rain-1/nora-b106/square-p3/programming/README.md

# First tests: Dragon P3.2 (P1-compatible pinout)

This low-cost CMSIS-DAP route has now passed basic SWD, LED, flash and UART
tests on one minimum assembly with a Pico 2 W. See [the bring-up record](BRINGUP.md)
and [separate BLE firmware](../firmware/ble/README.md). USB is still untested.
The NORA-B106 uses a dual-core nRF5340; use software with
nRF53 support, not an nRF52 target file. The manufacturer's documented supported
programmer route is SEGGER J-Link. Keep that as a fallback if your particular
Pico firmware/tool version cannot attach or recover this device.

## Set up the Pico

Use the official Raspberry Pi `debugprobe_on_pico.uf2` release for an RP2040
Pico, or `debugprobe_on_pico2.uf2` for Pico 2. Hold BOOTSEL while connecting the
Pico by USB and copy the matching UF2 onto its USB drive. Do not use the
`debugprobe.uf2` image intended for the separate Debug Probe accessory.

Firmware and instructions:
https://github.com/raspberrypi/debugprobe/releases/tag/debugprobe-v2.3.1
https://www.raspberrypi.com/documentation/microcontrollers/pico-series.html

## OpenOCD version requirement

**Debian 13's packaged OpenOCD 0.12.0 does not support the nRF5340. Installing
`openocd` from its standard repositories is insufficient for these steps.**
Use a newer OpenOCD binary and the scripts installed with that same build;
copying just `nrf53.cfg` into an old installation is insufficient because the
flash driver also needs nRF53 support. Do not substitute `nrf52.cfg`.

One source-build route on Debian 13 is below. This pins the upstream source
revision inspected for this project; it installs under the ignored `build/`
directory and does not replace the system OpenOCD. From the project root:

```sh
sudo apt install build-essential git autoconf automake libtool pkg-config \
  texinfo libusb-1.0-0-dev libhidapi-dev libjim-dev libssl-dev
git clone https://github.com/openocd-org/openocd.git build/tools/openocd-src
git -C build/tools/openocd-src checkout 2893f940012e19cda8ccb6038766b0d77f26bd0e
(
  cd build/tools/openocd-src
  ./bootstrap
  ./configure --prefix="$(pwd)/../openocd" \
    --enable-cmsis-dap --enable-cmsis-dap-v2 --disable-werror
  make -j2
  make install
)
export PATH="$PWD/build/tools/openocd/bin:$PATH"
openocd --version
```

For non-root USB access, install the upstream device rules once, then unplug
and reconnect the Pico:

```sh
sudo install -m 644 build/tools/openocd-src/contrib/60-openocd.rules \
  /etc/udev/rules.d/60-openocd.rules
sudo udevadm control --reload-rules
```

If the source checkout already exists, skip `git clone`. Reapply the PATH line
in each new terminal. Check the target configuration without connecting to
hardware:

```sh
openocd -f programming/pico-nrf53.cfg -c 'noinit; echo [target names]; shutdown'
```

This should list `nrf53.cpuapp` and `nrf53.cpunet`. It proves that the installed
binary can parse the target/flash-driver configuration, not that a Pico can
program a physical module. The project config accepts both the older
`target/nrf53.cfg` and newer `target/nordic/nrf53.cfg` script locations.
Upstream [build instructions](https://github.com/openocd-org/openocd/blob/2893f940012e19cda8ccb6038766b0d77f26bd0e/README.md)
and the [Debian 13 package version](https://packages.debian.org/trixie/openocd)
document the two installation routes. SEGGER J-Link remains the manufacturer's
supported alternative.

In the separate original revision D workspace, that pinned OpenOCD revision was built at
`build/tools/openocd/bin/openocd`, with build dependencies extracted under
`build/tools/openocd-deps/` rather than installed system-wide. The offline
configuration check passed for both cores. These ignored local binaries are
not included in Git or the project ZIP; use the build recipe on a fresh
checkout. No USB adapter or target was connected during this check.

## Wire the target

Connect GND first, then signals, with power removed while wiring.
The Pico pins here refer to the **debugger Pico**, not its own three debug pads.

| Debugger Pico | Physical pin | Carrier |
|---|---|---|
| GND | 3, or another GND | J2 pin 2, GND |
| GP2 | 4 | J2 pin 3, SWCLK |
| GP3 | 5 | J2 pin 4, SWDIO |
| GP1 | 2 | J2 pin 5, RESET_N; optional initially |
| 3V3 OUT | 36 | J2 pin 1 **only with JP1 open and external 3.3 V selected** |

For the USB assembly, fit the complete USB group, bridge JP1, power through USB and leave
Pico 3V3 OUT disconnected. Both variants use 3.3 V signalling. Do not connect
Pico VBUS/VSYS to this 3.3 V header. The Pico firmware has no target voltage
measurement, so verify the rail with a multimeter before connecting signals.

For UART later: J3 pin 3 (target P0.24 TX) goes to Pico GP5 (RX, physical 7),
and J3 pin 4 (target P1.06 RX) goes to Pico GP4 (TX, physical 6). Your firmware
must first configure these target pins as UART.

## Read-only identification

From the project root:

```sh
openocd -f programming/pico-nrf53.cfg \
  -c 'init; targets nrf53.cpuapp; halt; mdw 0x00FF0204 3; shutdown'
```

This attempts to halt the application core and read its FICR device-ID words
and part code. It does not erase or program flash. The CPU remains halted;
power-cycle afterward to restart existing firmware. Successful attach/read
shows that power and basic SWD communication work; it is not a complete
functional test of both cores.

## Blink the LED without building firmware

Connect an external LED: J3 pin 13 (P0.20) → 1 kohm resistor → LED anode,
LED cathode → J3 pin 2 (GND). Then run:

```sh
openocd -f programming/pico-nrf53.cfg -f programming/led-test.cfg
```

The script uses the secure GPIO alias to blink P0.20 six times while halted,
then restores that pin's prior configuration/output. It writes only GPIO
registers, not flash, UICR, or protection settings. It requires unlocked secure
application-core access. With existing firmware that changes security/ownership,
this test may be unavailable even if the board is healthy. If access is denied,
check wiring, supply voltage, adapter firmware, and protection state first.

**Do not blindly run recover/mass erase.** nRF53 recovery can erase both cores
and UICR, including manufacturer production data such as the stored Bluetooth
address. Back up accessible flash/UICR before destructive operations, and use
the manufacturer's recovery/identity-restoration procedure if recovery is
actually necessary. None of the provided scripts performs recovery.

## Built USB firmware

The implemented USB recovery bootloader and GPIO/ADC serial test application
are documented in [Minimal P1 firmware guide](../../minimal-p1/firmware/README.md). The initial SWD
image is `../minimal-p1/firmware/dist/nora-factory.hex`; later USB updates use
`../minimal-p1/firmware/dist/nora-app.signed.bin`. Both have been compiled and statically
checked for the electrically compatible Minimal P1 board, but no hardware programming/USB session has
been tested. Follow the new guide for installation, `nora dfu`, USB uploads and
external GPIO/LED testing. Do not flash the application ELF alone as a factory
image: it needs the signed MCUboot header and matching bootloader.

`../minimal-p1/firmware/blinky/` remains the earlier standalone example source and is not the
USB application. The USB build uses its own board definition rather than the
Nordic DK configuration. No Bluetooth/network-core image is included.

## P3.2 first USB firmware install

P3.2 retains P1's J2/J3 mapping, module power and USB D+/D−/VBUS interfaces.
Its USB-C socket and two CC resistors do not require a firmware change. Use
the unchanged P1 bootloader and application pair (USB names still say P1).
After the power and read-only SWD checks above, fit all USB parts, bridge JP1,
power through USB and disconnect Pico 3V3 OUT. From `square-p3/`:

```sh
openocd -f programming/pico-nrf53.cfg \
  -c 'init; targets nrf53.cpuapp; program ../minimal-p1/firmware/dist/nora-factory.hex verify reset exit'
```

USB serial commands are in the shared firmware guide. `nora pins` lists J3
pins 3–14; the external LED is pin 13, ADC is pin 14. For a later USB update,
run the shared updater from `minimal-p1/`, following that firmware guide.
No P2 firmware should be used on this twelve-GPIO board.

## Optional reset button

If SW1 is fitted, press and release it to reset the target. With the shared P1
USB bootloader installed, a RESET_N reset stays in USB recovery until commanded
to reset. A normal power-on gives the usual eight-second recovery window.
`nora dfu` remains available from the application, and J2 pin 5 still permits an
external reset wire/button if SW1 is omitted. SW1 is not a separate boot-mode
strap and does not change any GPIO header mapping.

## USB-C cable

Use a data-capable USB-A-to-C or USB-C-to-C cable to a computer. Both plug
orientations are wired. Fit R1/R2 and all other USB parts, close JP1 for USB
power, and leave the debugger Pico's 3V3 OUT disconnected. SW1 and `nora dfu`
enter the same shared P1 recovery mode as before. A bare module still needs
its initial SWD installation; changing the connector does not add a ROM USB
bootloader or turn this into a drag-and-drop UF2 drive.
