rain-1/nora-b106/square-p3/artwork/PROMPT.md

# Generation prompt

Tool: built-in `image_gen.imagegen`, new image, opaque white background.

Use case: logo-brand. Asset type: one-colour PCB back silkscreen artwork, to be traced into manufacturing vectors at about 26 mm wide and 23 mm tall. Primary request: a very cool cyber dragon emblem. Draw a single stylized angular cybernetic dragon, serpentine curling neck and tail, recognisable fierce horned head looking to the upper right, one swept segmented bat wing, geometric armour plates and a few thick circuit-trace details. Powerful clean silhouette, elegant balanced asymmetrical composition, compact badge shape with no enclosing border. Flat pure solid black design on a pure white background, large continuous black shapes and broad white cutout spaces. No text, no lettering, no watermarks, no gradients, no grey, no texture, no shading, no simulated PCB, no fine hatching, no tiny dots. Important for fabrication: bold simple details with thick strokes, wide gaps and rounded-safe small corners, read clearly at 26 millimetres; very few broad circuit traces integrated into body rather than a detailed background. Plenty of white margin. This is the black artwork mask only; it will be printed as white ink on green soldermask.
