rain-1/nora-b106/square-p3/artwork/cyber-dragon-source.png

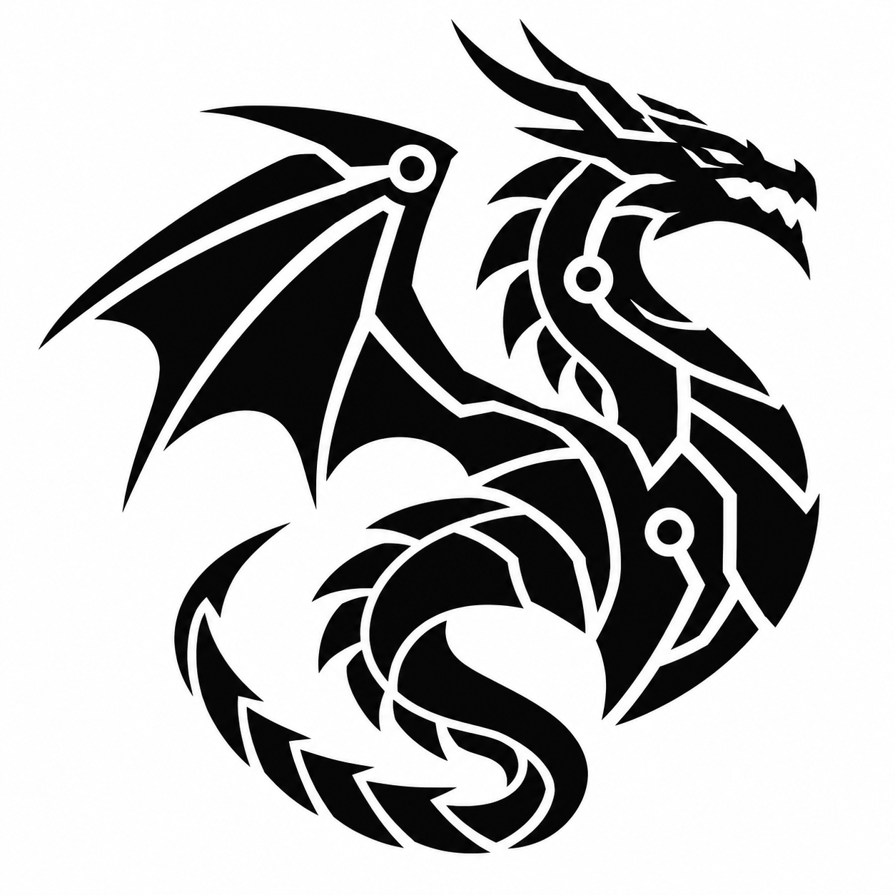
square-p3/artwork/cyber-dragon-source.png
