rain-1/nora-b106/square-p3/preview/back-artwork.png

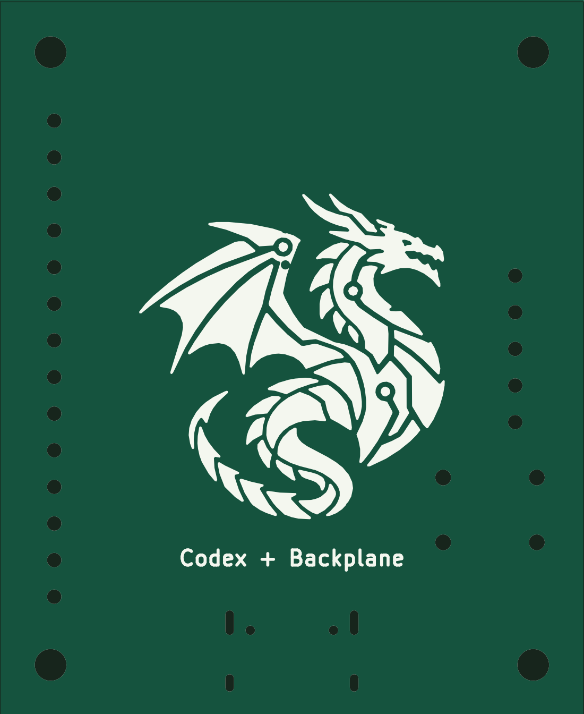
square-p3/preview/back-artwork.png
