rain-1/nora-b106/square-p3/preview/board-top.png

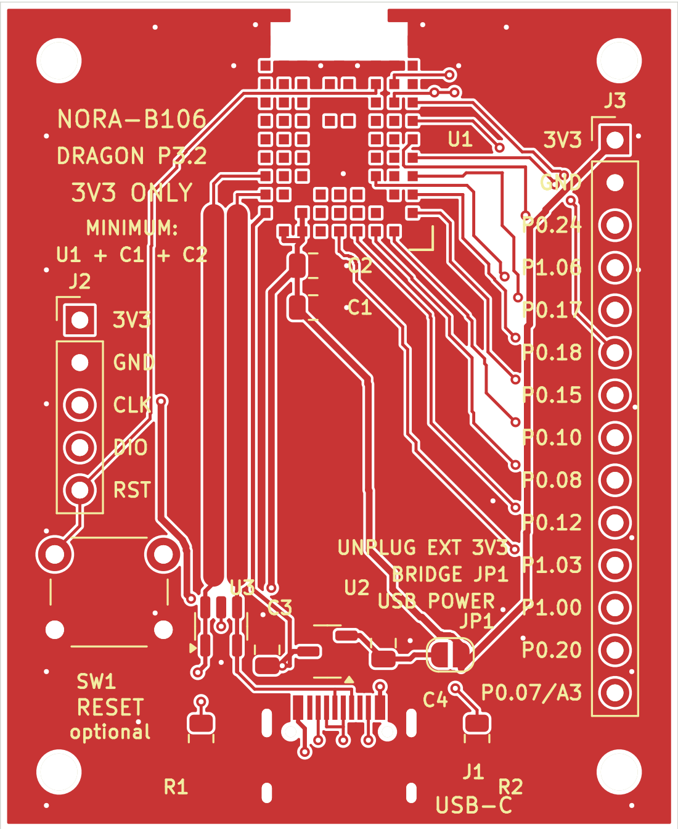
square-p3/preview/board-top.png
