rain-1/nora-b106/square-p3/preview/nora-minimal.png

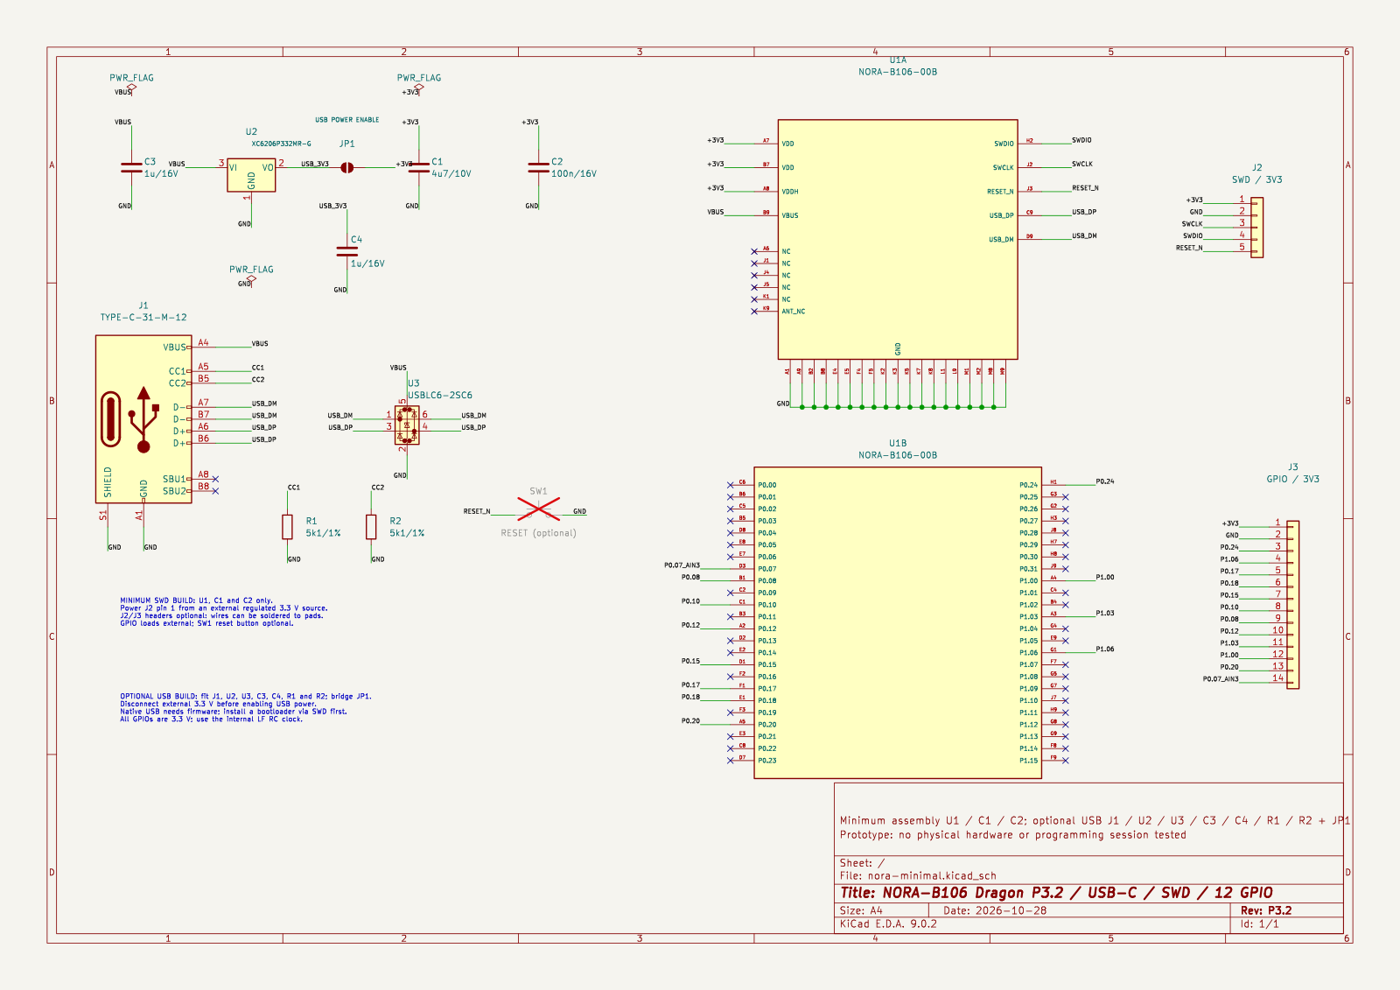
square-p3/preview/nora-minimal.png
