rain-1/nora-b106/fabrication/preview/assembly-top.png

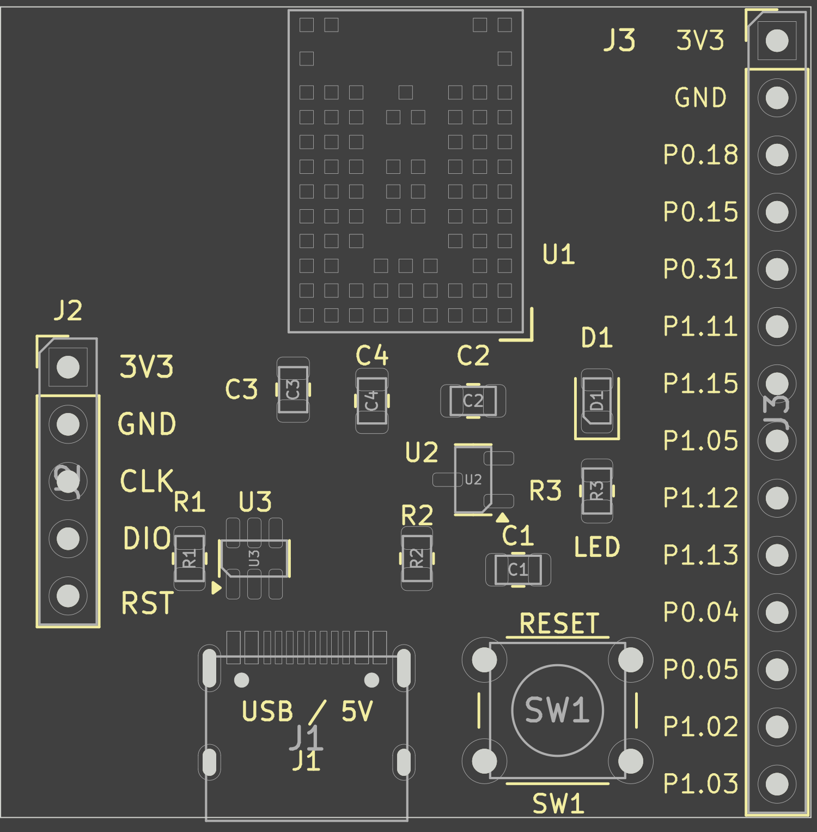
fabrication/preview/assembly-top.png
