rain-1/nora-b106/fabrication/preview/copper-bottom.png

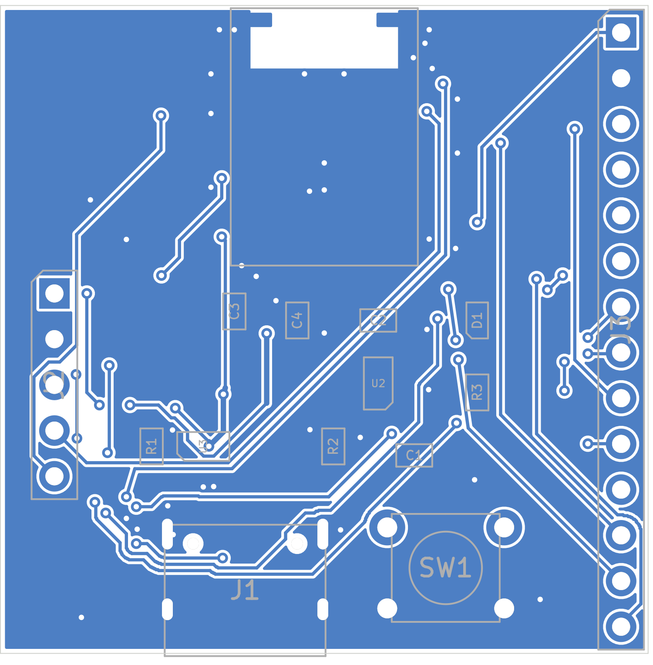
fabrication/preview/copper-bottom.png
