rain-1/nora-b106/fabrication/preview/copper-top.png

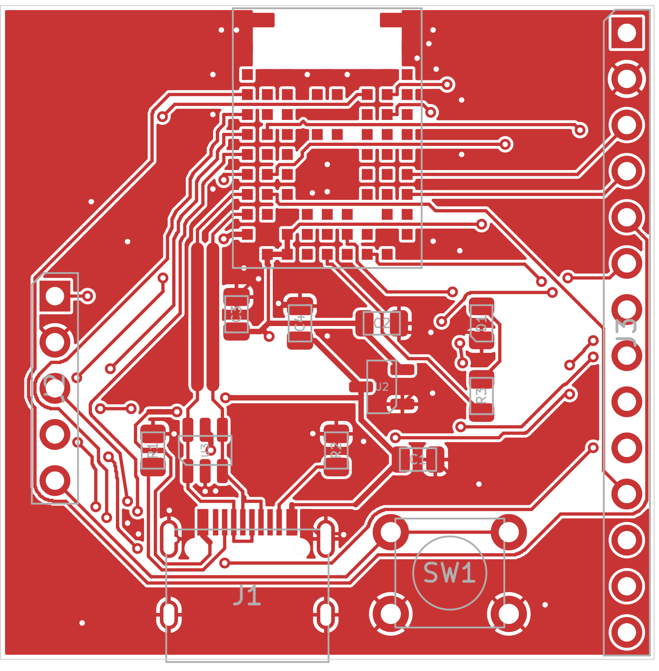
fabrication/preview/copper-top.png
