rain-1/nora-b106/fabrication/preview/nora-b106-board.png

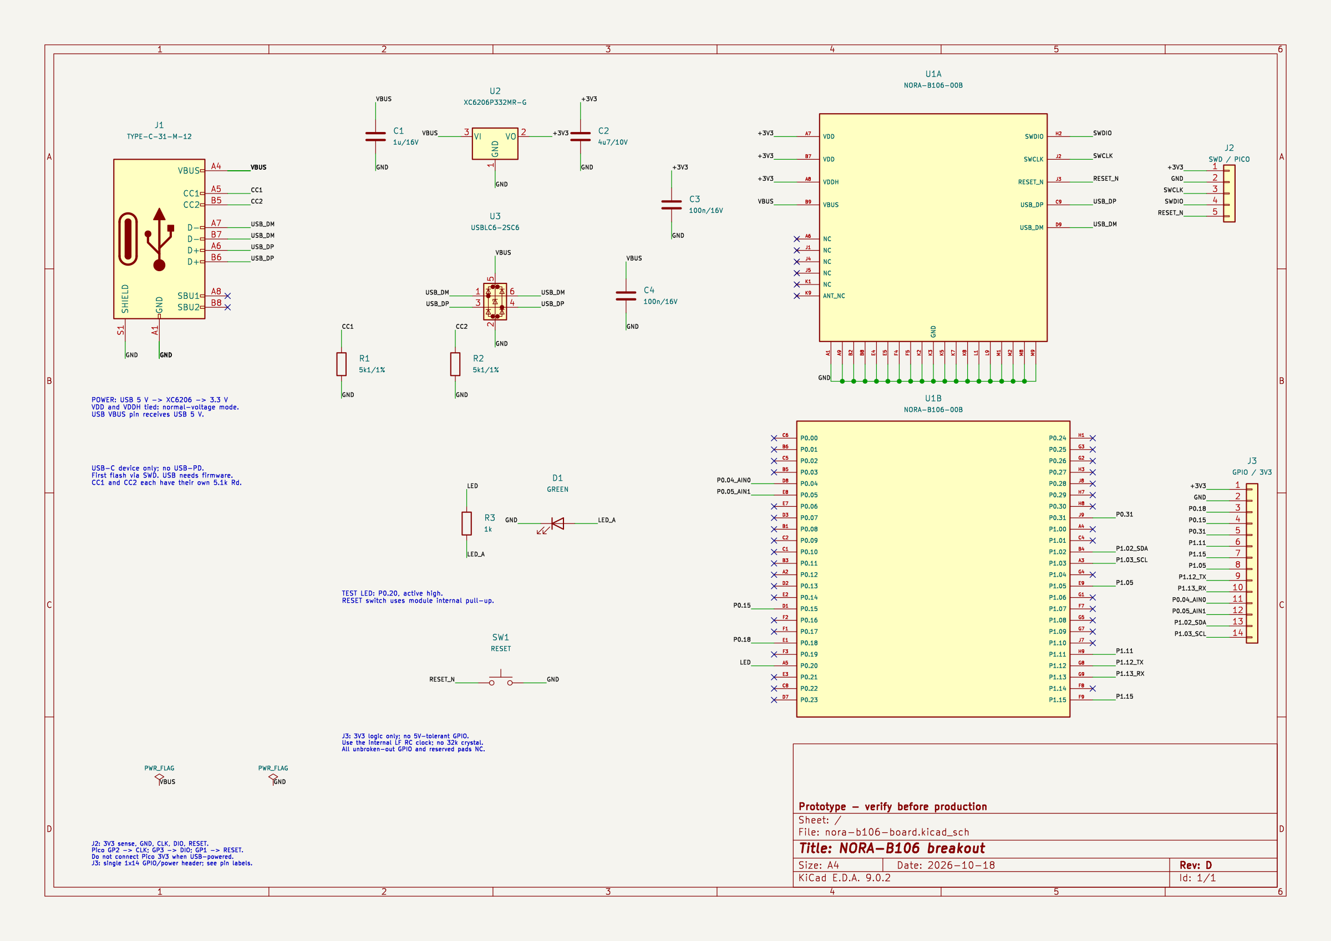
fabrication/preview/nora-b106-board.png
