rain-1/nora-b106/minimal-p1/preview/assembly.png

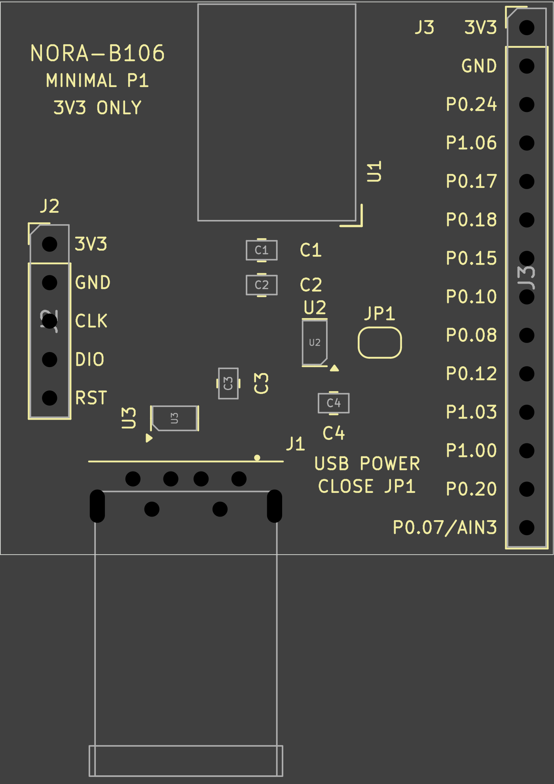
minimal-p1/preview/assembly.png
