rain-1/nora-b106/minimal-p2/preview/assembly.png

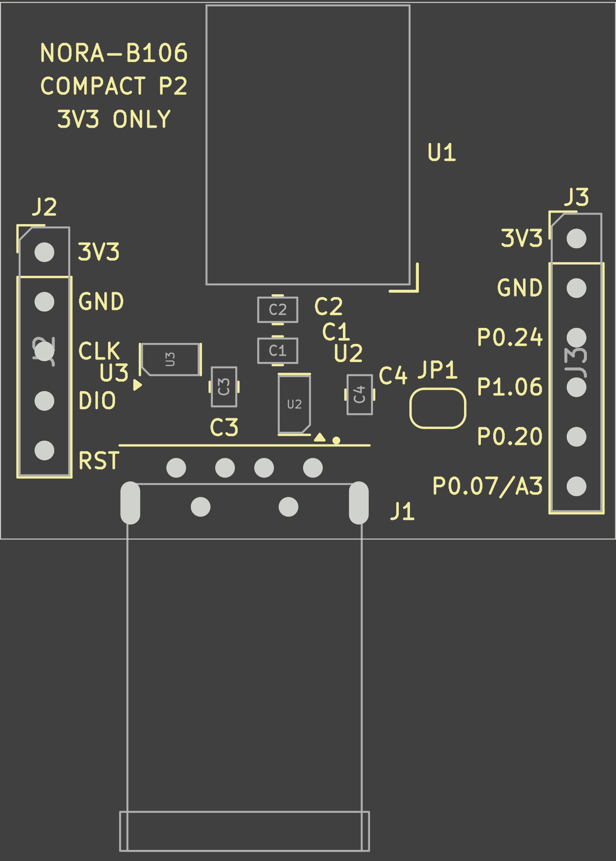
minimal-p2/preview/assembly.png
