rain-1/nora-b106/square-p3/preview/assembly.png

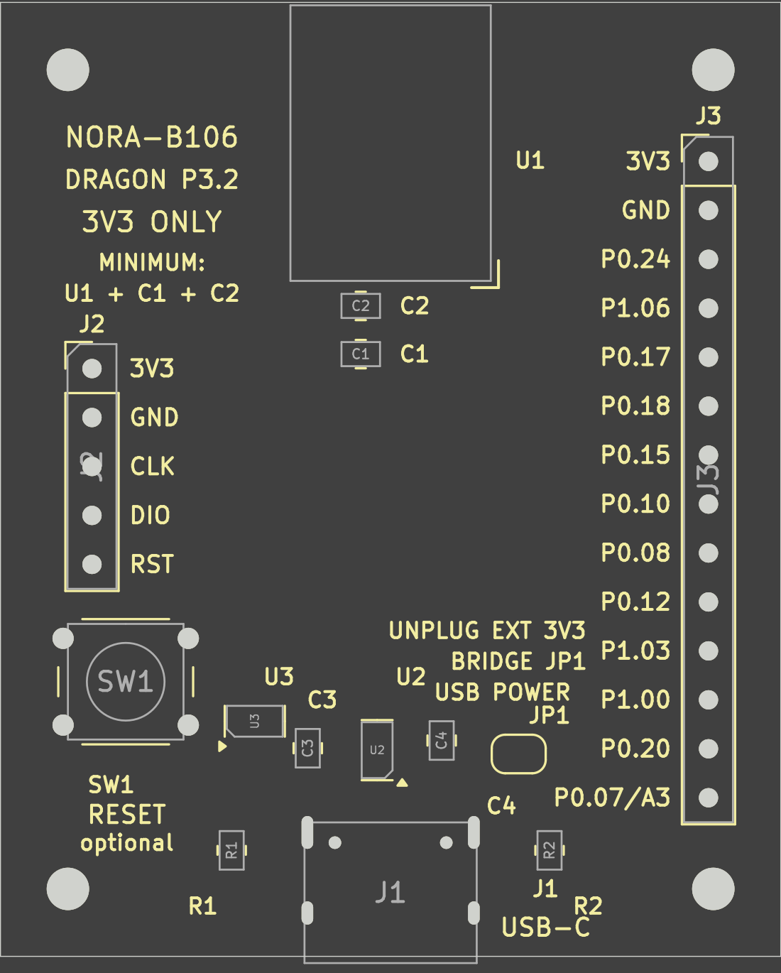
square-p3/preview/assembly.png
