rain-1/nora-b106/square-p3/nora-minimal.kicad_pcb

## KiCad design square-p3/nora-minimal.kicad_pcb (2026-10-28)

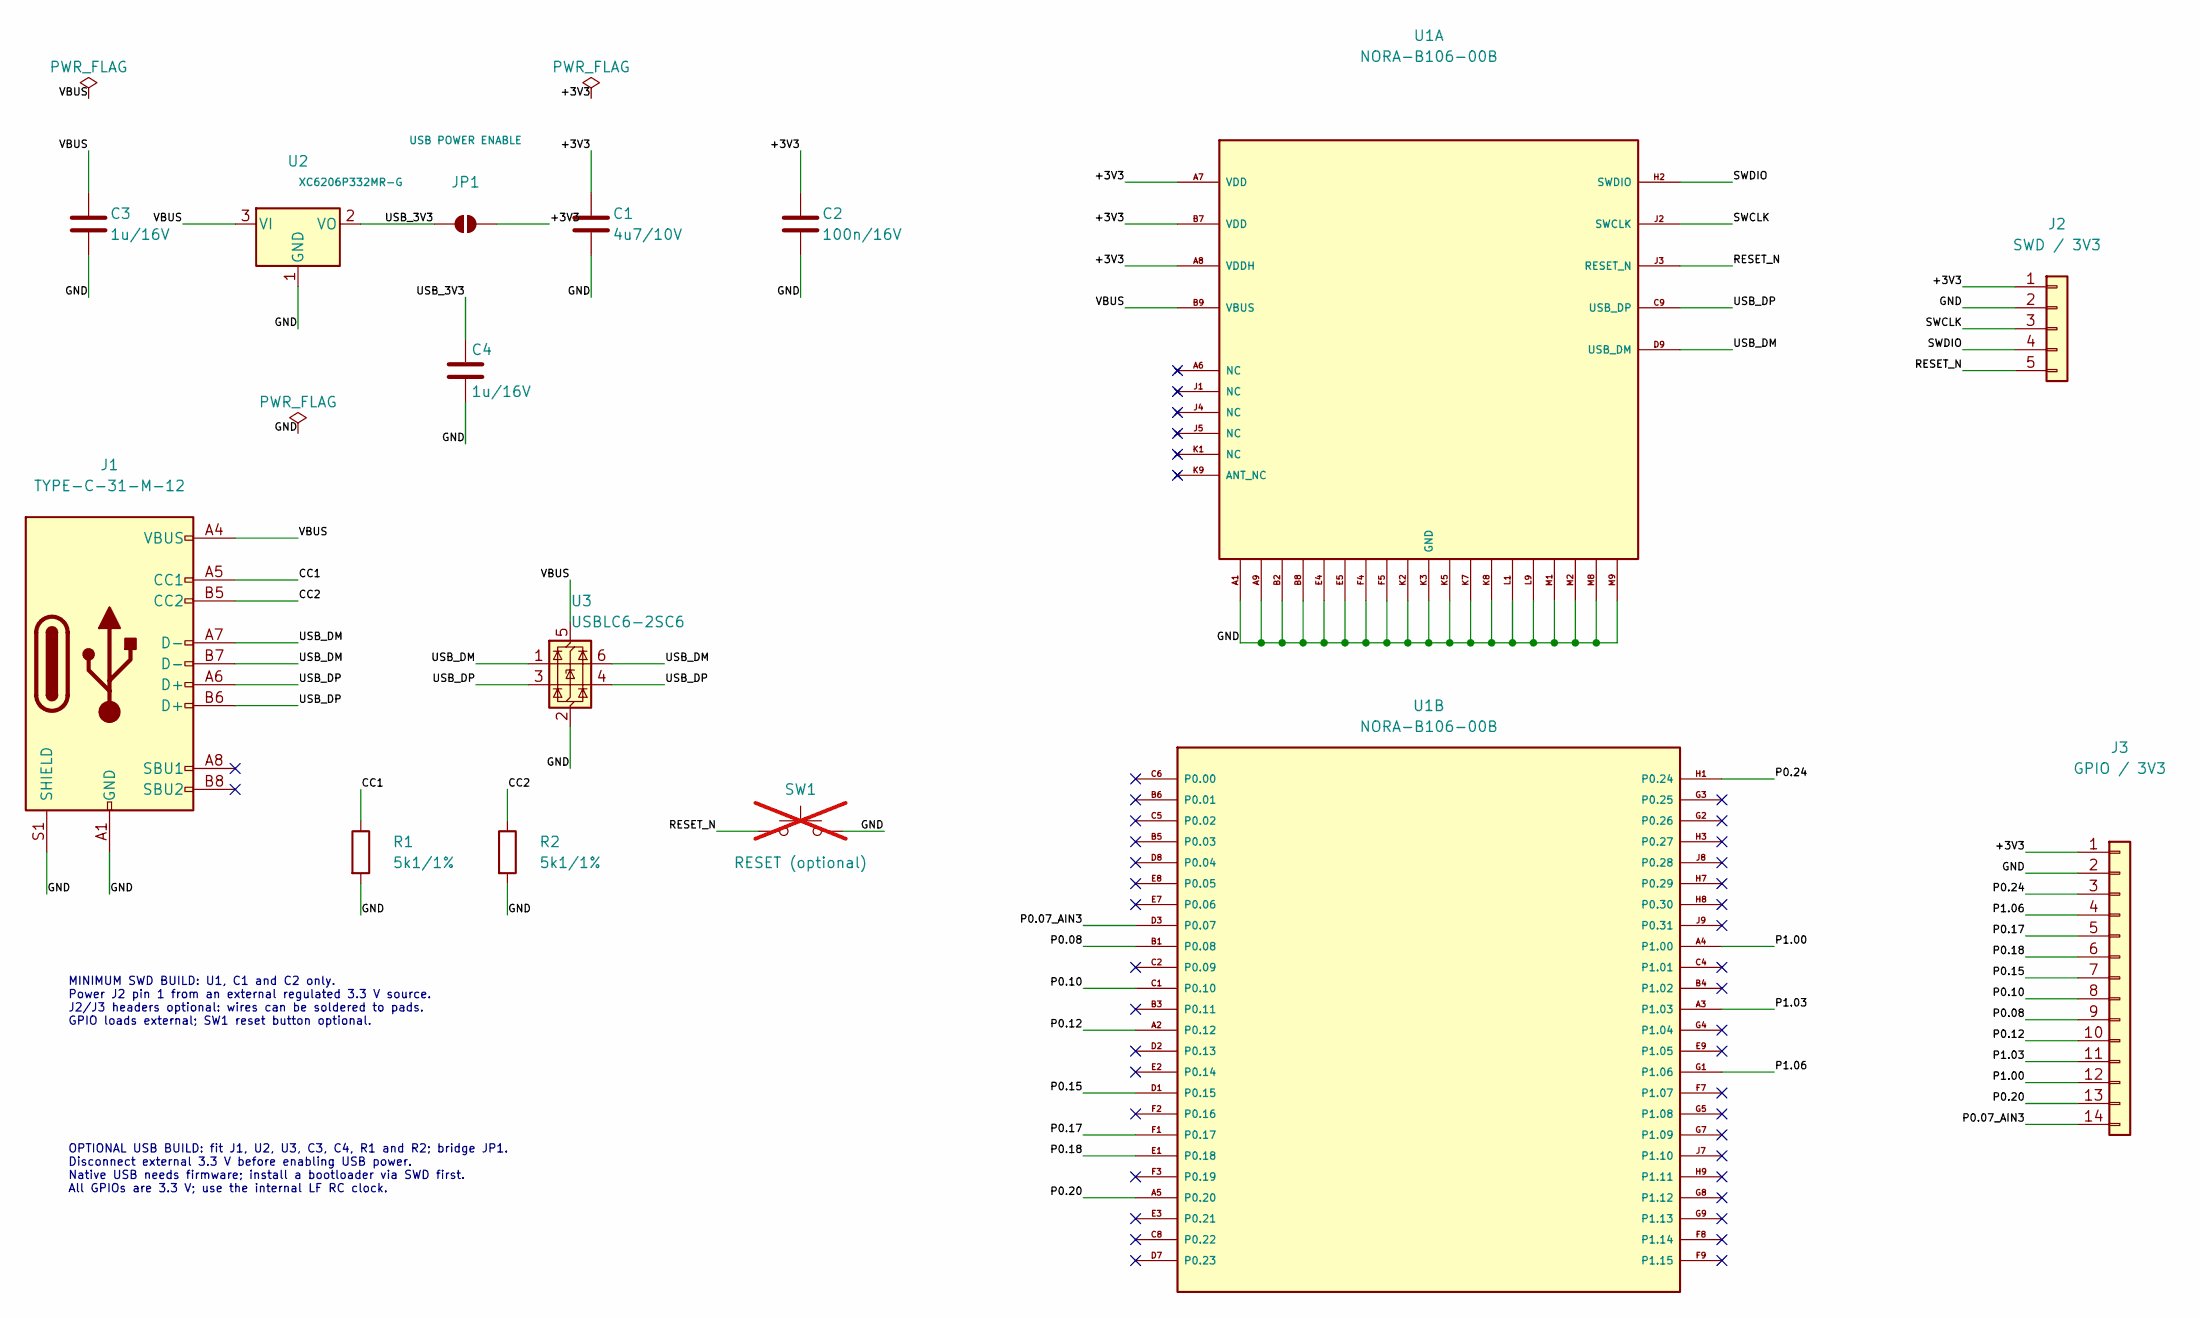
[picture p14: schematic nora-minimal.kicad_sch, NORA-B106 Dragon P3.2 / USB-C / SWD / 12 GPIO]

Parts:
C1: 4u7/10V; C_0805_2012Metric
C2: 100n/16V; C_0805_2012Metric
C3, C4: 1u/16V; C_0805_2012Metric
J1: TYPE-C-31-M-12; USB_C_Receptacle_HRO_TYPE-C-31-M-12
J2: SWD / 3V3; PinHeader_1x05_P2.54mm_Vertical
J3: GPIO / 3V3; PinHeader_1x14_P2.54mm_Vertical
JP1: USB POWER ENABLE; SolderJumper-2_P1.3mm_Open_RoundedPad1.0x1.5mm
R1, R2: 5k1/1%; R_0805_2012Metric
SW1: RESET (optional); SW_PUSH_6mm; not fitted
U1: NORA-B106-00B; NORA-B106
U2: XC6206P332MR-G; SOT-23-3
U3: USBLC6-2SC6; SOT-23-6

Connections:
/+3V3: C1.1, C2.1, J2.1, J3.1, JP1.2 (B), U1.A7 (VDD), U1.A8 (VDDH), U1.B7 (VDD)
/CC1: J1.A5 (CC1), R1.1
/CC2: J1.B5 (CC2), R2.1
/GND: C1.2, C2.2, C3.2, C4.2, J1.A1 (GND), J1.A12 (GND), J1.B1 (GND), J1.B12 (GND), J1.S1 (SHIELD), J2.2, J3.2, R1.2, R2.2, SW1.2, U1.A1, U1.A9, U1.B2, U1.B8, U1.E4, U1.E5, U1.F4, U1.F5, U1.K2, U1.K3 (GND), U1.K5, U1.K7, U1.K8, U1.L1, U1.L9, U1.M1, U1.M2, U1.M8, U1.M9, U2.1 (GND), U3.2 (GND)
/P0.07_AIN3: J3.14, U1.D3 (P0.07)
/P0.08: J3.9, U1.B1 (P0.08)
/P0.10: J3.8, U1.C1 (P0.10)
/P0.12: J3.10, U1.A2 (P0.12)
/P0.15: J3.7, U1.D1 (P0.15)
/P0.17: J3.5, U1.F1 (P0.17)
/P0.18: J3.6, U1.E1 (P0.18)
/P0.20: J3.13, U1.A5 (P0.20)
/P0.24: J3.3, U1.H1 (P0.24)
/P1.00: J3.12, U1.A4 (P1.00)
/P1.03: J3.11, U1.A3 (P1.03)
/P1.06: J3.4, U1.G1 (P1.06)
/RESET_N: J2.5, SW1.1, U1.J3 (RESET_N)
/SWCLK: J2.3, U1.J2 (SWCLK)
/SWDIO: J2.4, U1.H2 (SWDIO)
/USB_3V3: C4.1, JP1.1 (A), U2.2 (VO)
/USB_DM: J1.A7 (D-), J1.B7 (D-), U1.D9 (USB_DM), U3.1 (I/O1), U3.6 (I/O1)
/USB_DP: J1.A6 (D+), J1.B6 (D+), U1.C9 (USB_DP), U3.3 (I/O2), U3.4 (I/O2)
/VBUS: C3.1, J1.A4 (VBUS), J1.A9 (VBUS), J1.B4 (VBUS), J1.B9 (VBUS), U1.B9 (VBUS), U2.3 (VI), U3.5 (VBUS)

Notes on the sheet:
OPTIONAL USB BUILD: fit J1, U2, U3, C3, C4, R1 and R2; bridge JP1. Disconnect external 3.3 V before enabling USB power. Native USB needs firmware; install a bootloader via SWD first. All GPIOs are 3.3 V; use the internal LF RC clock.
MINIMUM SWD BUILD: U1, C1 and C2 only. Power J2 pin 1 from an external regulated 3.3 V source. J2/J3 headers optional: wires can be soldered to pads. GPIO loads external; SW1 reset button optional.

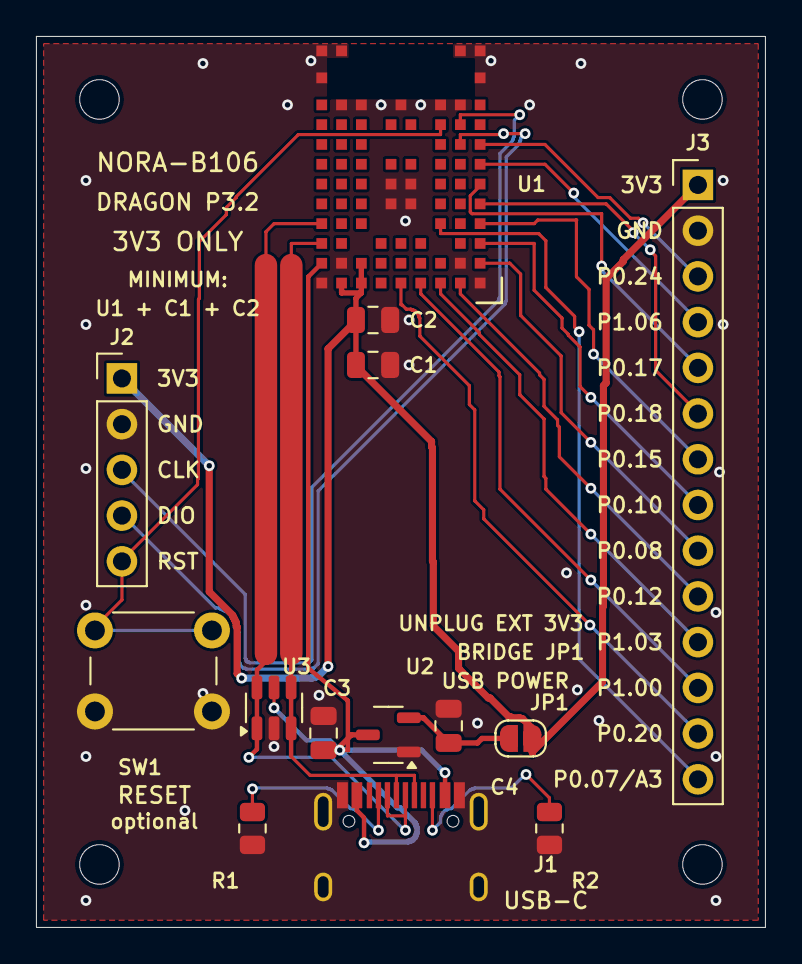
[picture p15: board nora-minimal.kicad_pcb from above]

Board: 2 copper layers, 40.5 x 49.5 mm, 18 parts (0 on the bottom side), 23 nets.

Other parts of the board:
H1, H2, H3, H4: MountingHole_2.2mm_M2
