rain-1/nora-b106/nora-b106-board.kicad_pcb

## KiCad design nora-b106-board.kicad_pcb (2026-10-18)

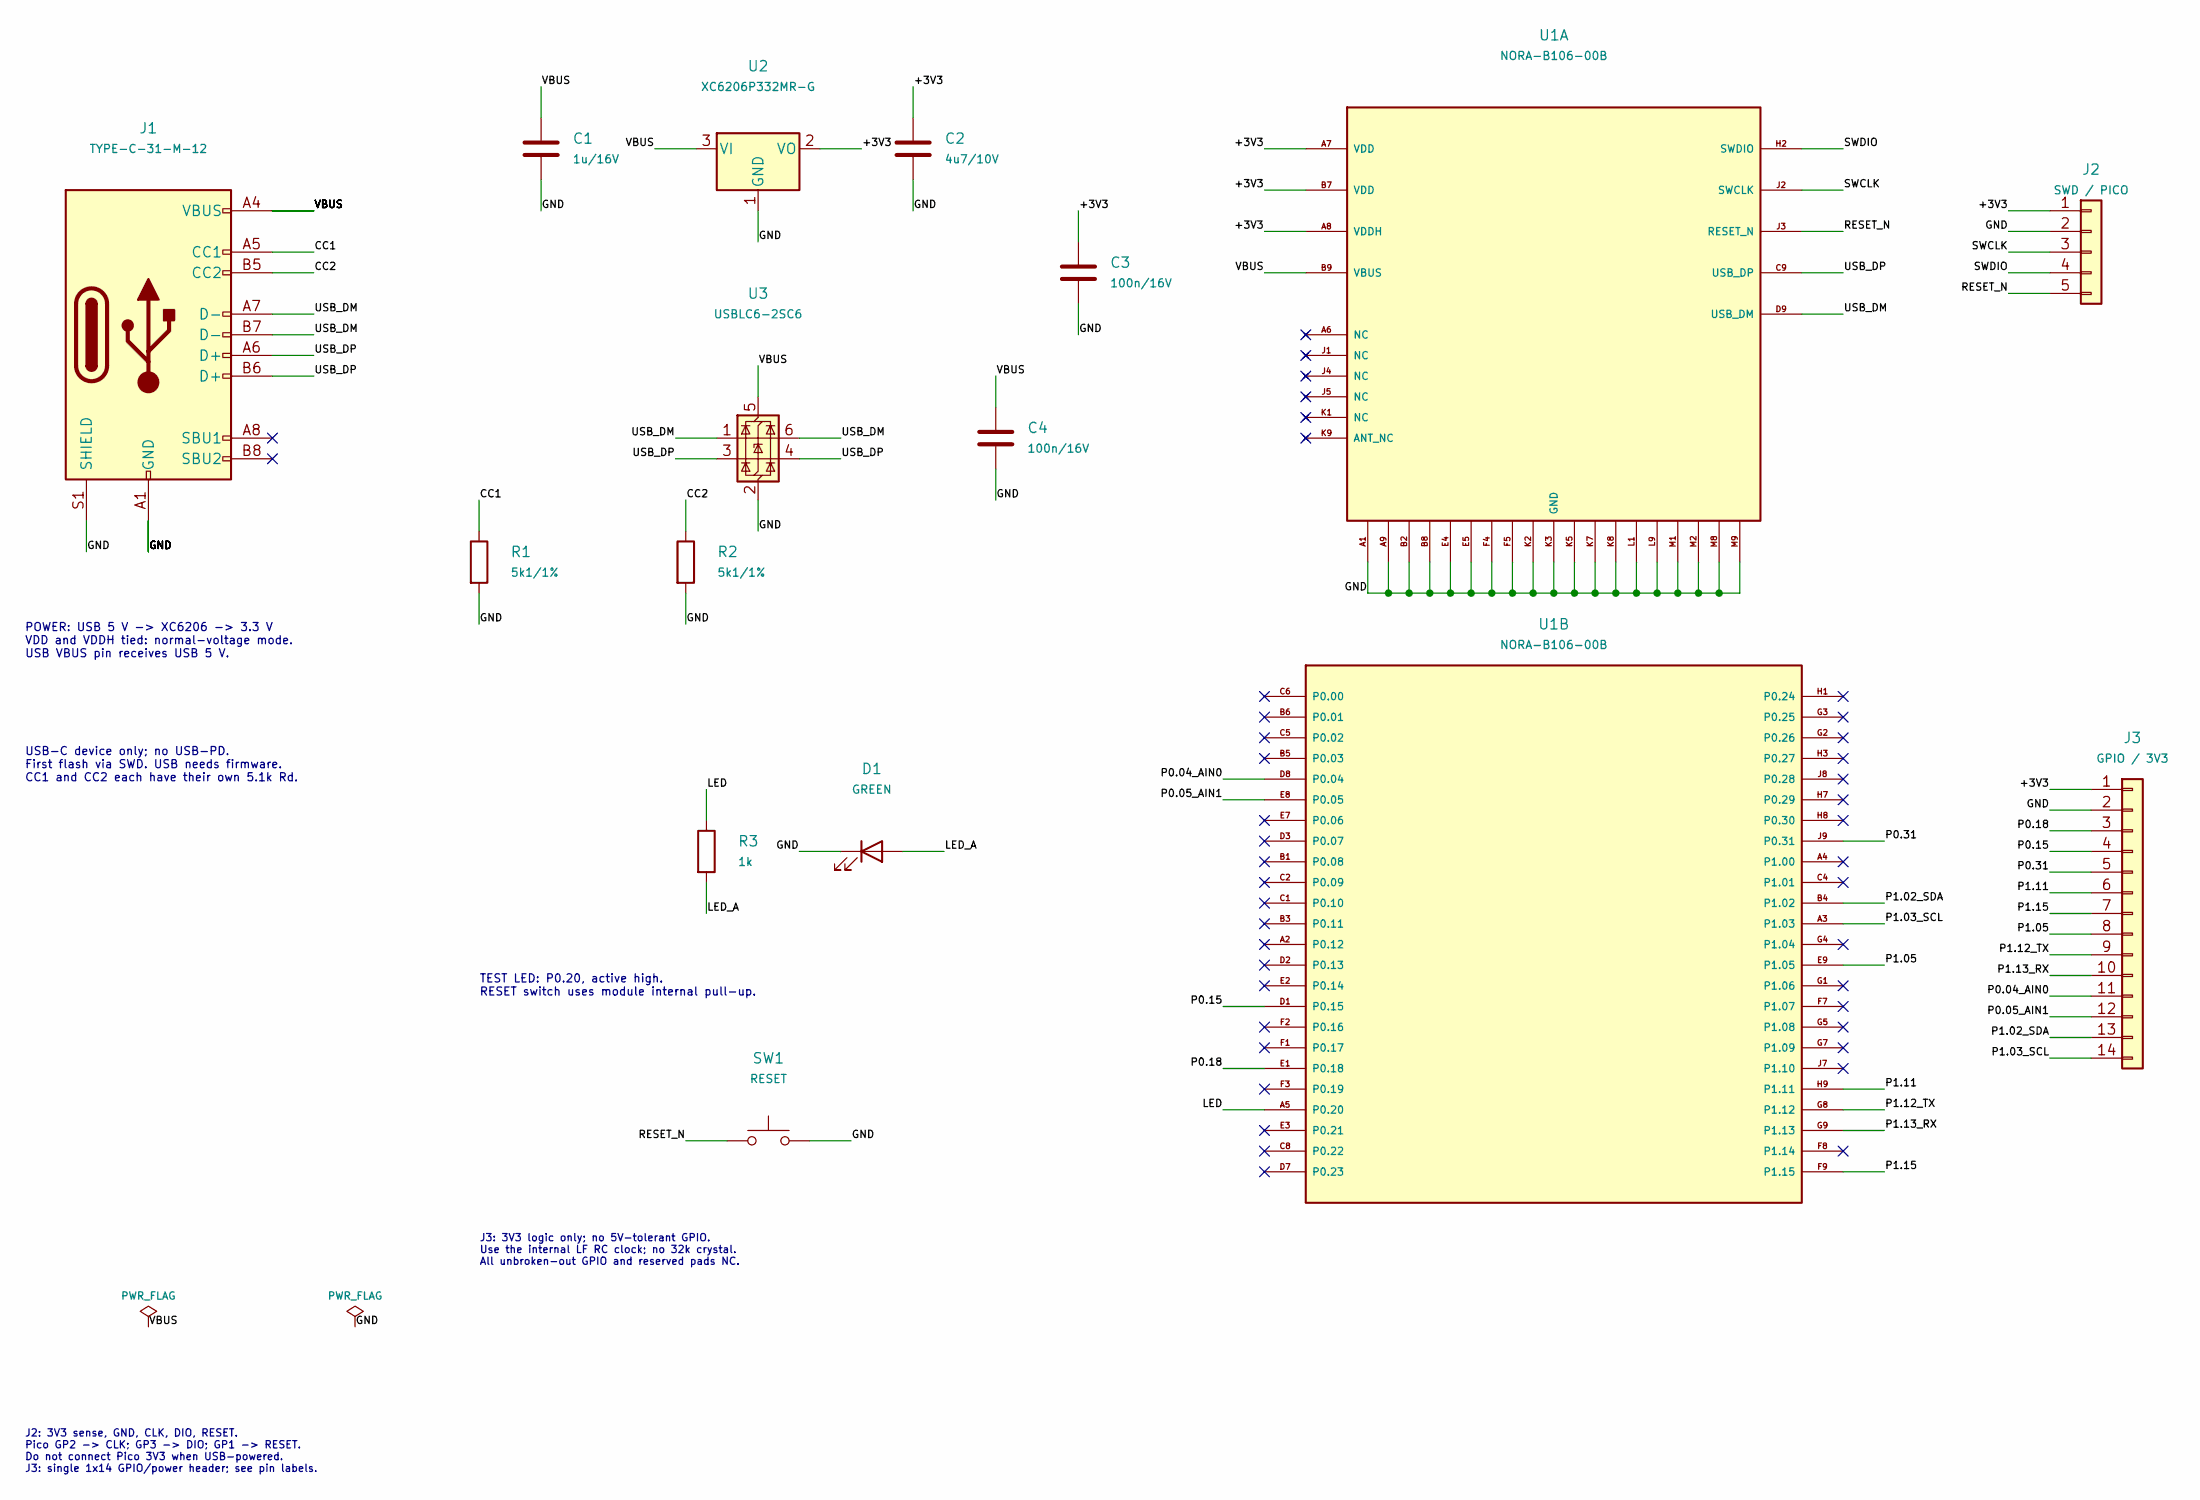
[picture p16: schematic nora-b106-board.kicad_sch, NORA-B106 breakout]

Parts:
C1: 1u/16V; C_0805_2012Metric
C2: 4u7/10V; C_0805_2012Metric
C3, C4: 100n/16V; C_0805_2012Metric
D1: GREEN; LED_0805_2012Metric
J1: TYPE-C-31-M-12; USB_C_Receptacle_HRO_TYPE-C-31-M-12
J2: SWD / PICO; PinHeader_1x05_P2.54mm_Vertical
J3: GPIO / 3V3; PinHeader_1x14_P2.54mm_Vertical
R1, R2: 5k1/1%; R_0805_2012Metric
R3: 1k; R_0805_2012Metric
SW1: RESET; SW_PUSH_6mm
U1: NORA-B106-00B; NORA-B106
U2: XC6206P332MR-G; SOT-23-3
U3: USBLC6-2SC6; SOT-23-6

Connections:
/+3V3: C2.1, C3.1, J2.1, J3.1, U1.A7 (VDD), U1.A8 (VDDH), U1.B7 (VDD), U2.2 (VO)
/CC1: J1.A5 (CC1), R1.1
/CC2: J1.B5 (CC2), R2.1
/GND: C1.2, C2.2, C3.2, C4.2, D1.1 (K), J1.A1 (GND), J1.A12 (GND), J1.B1 (GND), J1.B12 (GND), J1.S1 (SHIELD), J2.2, J3.2, R1.2, R2.2, SW1.2, U1.A1, U1.A9, U1.B2, U1.B8, U1.E4, U1.E5, U1.F4, U1.F5, U1.K2, U1.K3 (GND), U1.K5, U1.K7, U1.K8, U1.L1, U1.L9, U1.M1, U1.M2, U1.M8, U1.M9, U2.1 (GND), U3.2 (GND)
/LED: R3.1, U1.A5 (P0.20)
/LED_A: D1.2 (A), R3.2
/P0.04_AIN0: J3.11, U1.D8 (P0.04)
/P0.05_AIN1: J3.12, U1.E8 (P0.05)
/P0.15: J3.4, U1.D1 (P0.15)
/P0.18: J3.3, U1.E1 (P0.18)
/P0.31: J3.5, U1.J9 (P0.31)
/P1.02_SDA: J3.13, U1.B4 (P1.02)
/P1.03_SCL: J3.14, U1.A3 (P1.03)
/P1.05: J3.8, U1.E9 (P1.05)
/P1.11: J3.6, U1.H9 (P1.11)
/P1.12_TX: J3.9, U1.G8 (P1.12)
/P1.13_RX: J3.10, U1.G9 (P1.13)
/P1.15: J3.7, U1.F9 (P1.15)
/RESET_N: J2.5, SW1.1, U1.J3 (RESET_N)
/SWCLK: J2.3, U1.J2 (SWCLK)
/SWDIO: J2.4, U1.H2 (SWDIO)
/USB_DM: J1.A7 (D-), J1.B7 (D-), U1.D9 (USB_DM), U3.1 (I/O1), U3.6 (I/O1)
/USB_DP: J1.A6 (D+), J1.B6 (D+), U1.C9 (USB_DP), U3.3 (I/O2), U3.4 (I/O2)
/VBUS: C1.1, C4.1, J1.A4 (VBUS), J1.A9 (VBUS), J1.B4 (VBUS), J1.B9 (VBUS), U1.B9 (VBUS), U2.3 (VI), U3.5 (VBUS)

Notes on the sheet:
POWER: USB 5 V -> XC6206 -> 3.3 V VDD and VDDH tied: normal-voltage mode. USB VBUS pin receives USB 5 V.
USB-C device only; no USB-PD. First flash via SWD. USB needs firmware. CC1 and CC2 each have their own 5.1k Rd.
TEST LED: P0.20, active high. RESET switch uses module internal pull-up.
J2: 3V3 sense, GND, CLK, DIO, RESET. Pico GP2 -> CLK; GP3 -> DIO; GP1 -> RESET. Do not connect Pico 3V3 when USB-powered. J3: single 1x14 GPIO/power header; see pin labels.
J3: 3V3 logic only; no 5V-tolerant GPIO. Use the internal LF RC clock; no 32k crystal. All unbroken-out GPIO and reserved pads NC.

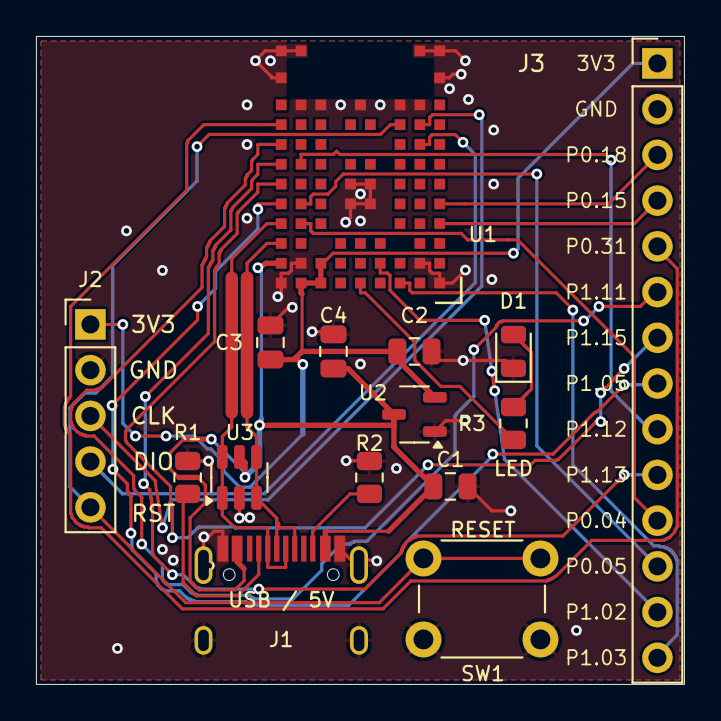
[picture p17: board nora-b106-board.kicad_pcb from above]

Board: 2 copper layers, 36.0 x 36.0 mm, 15 parts (0 on the bottom side), 24 nets.
