rain-1/nora-b106/minimal-p2/firmware/blinky/src/main.c

#include <zephyr/kernel.h>
#include <zephyr/drivers/gpio.h>

static const struct gpio_dt_spec led = GPIO_DT_SPEC_GET(DT_ALIAS(led0), gpios);

int main(void)
{
    if (!gpio_is_ready_dt(&led) || gpio_pin_configure_dt(&led, GPIO_OUTPUT_INACTIVE)) {
        return -1;
    }
    for (;;) {
        gpio_pin_toggle_dt(&led);
        k_msleep(500);
    }
    return 0;
}
