rain-1/nora-b106/(commit log)

2026-10-18 Add revision A NORA-B106 breakout and fabrication files
    [BOM.csv, led-test.cfg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]
2026-10-18 Improve module grounding and fix nRF53 programmer setup for revision B
    [nora-b106-board-B_Cu.gbl, nora-b106-board-B_Mask.gbs, nora-b106-board-B_Silkscreen.gbo, nora-b106-board-Edge_Cuts.gm1, nora-b106-board-F_Cu.gtl, nora-b106-board-F_Mask.gts, nora-b106-board-F_Paste.gtp, nora-b106-board-F_Silkscreen.gto]
2026-10-18 Expose six more GPIOs on optional headers in revision C
    [BOM.csv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]
2026-10-18 Consolidate GPIOs into one right-edge header in revision D
    [BOM.csv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]
2026-10-28 Add Minimal P1 breakout and built USB recovery firmware
    Publish the separate Backplane-designed SWD/GPIO/optional USB-A board as a
    validated KiCad 9 project, retaining the original fork files for provenance.
    Include bare-board fabrication files, population/power guidance, a pinned
    Zephyr/MCUboot build, signed factory/update images and GPIO/ADC USB console.
    ERC, DRC, schematic parity, module grounding and pad audits pass. Firmware
    build/static checks and eight uploader tests pass; hardware remains untested.
    The revision D hardware files are unchanged.
    [BOM.csv, led-test.cfg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]
2026-10-28 Add compact four-GPIO P2 breakout and matching USB firmware
    [BOM.csv, led-test.cfg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]
2026-10-28 Add 50 mm tier P3 breakout with twelve GPIOs and Codex signature
    [BOM.csv, led-test.cfg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]
2026-10-28 Narrow P3 board, centre USB and add cyber dragon artwork and optional reset
    [BOM.csv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]
2026-10-28 Switch Dragon P3.2 to USB-C and restore four mounting holes
    [BOM.csv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]
2026-10-28 Update JLCPCB order settings and remove retired order-number marker
    [nora-minimal-B_Cu.gbl, nora-minimal-B_Mask.gbs, nora-minimal-B_Silkscreen.gbo, nora-minimal-Edge_Cuts.gm1, nora-minimal-F_Cu.gtl, nora-minimal-F_Mask.gts, nora-minimal-F_Paste.gtp, nora-minimal-F_Silkscreen.gto]
2026-10-28 Remove owner references and back title and dimensions from PCB
    [nora-minimal-B_Cu.gbl, nora-minimal-B_Mask.gbs, nora-minimal-B_Silkscreen.gbo, nora-minimal-Edge_Cuts.gm1, nora-minimal-F_Cu.gtl, nora-minimal-F_Mask.gts, nora-minimal-F_Paste.gtp, nora-minimal-F_Silkscreen.gto]
2026-10-28 Remove prototype label from back silkscreen
    [nora-minimal-B_Cu.gbl, nora-minimal-B_Mask.gbs, nora-minimal-B_Silkscreen.gbo, nora-minimal-Edge_Cuts.gm1, nora-minimal-F_Cu.gtl, nora-minimal-F_Mask.gts, nora-minimal-F_Paste.gtp, nora-minimal-F_Silkscreen.gto]
2026-11-08 Add tested Dragon P3 BLE controls and signed Bluetooth updates
    [backup.cfg, ble-flash.cfg, ota-install.cfg, shopping-two-boards.csv]
